docteurzoidberg/claudemetre/design/references/fusible/README.md

# Porte-fusible 5 × 20 : modèle 3D de référence

Porte-fusible de panneau pour cartouche 5 × 20 mm, à capuchon moleté. Il doit
protéger l'arrivée 12 V sur le LP-16. Ce modèle sert à Fusion.

Source : archive GrabCAD `fuse-holder-5-20mm-cartidge-1.snapshot.2.zip`
(<https://grabcad.com/library/fuse-holder-5-20mm-cartidge-1>). Export Fusion, en mm.
Rien n'indique qu'il vient du fabricant : cotes à confirmer sur la pièce reçue.

| Fichier | Contenu |
| --- | --- |
| `fuse_holder.step` | porte-fusible, 7 solides : capuchon, corps, deux cosses, écrou, deux rondelles. Envoyé dans Fusion : `claudometre/models/porte_fusible_5x20` |
| `fuse_holder.jpg` | aperçu fourni avec le modèle |

## Repère

Z est l'axe du porte-fusible, +Z va vers le capuchon, l'origine est près du
sommet du capuchon. Dans le STEP, écrou et rondelles sont posés sur le filet,
sans panneau.

## Cotes

Mesurées sur le STEP.

| Élément | Diamètre | Z |
| --- | --- | --- |
| Capuchon | Ø 14 à la base, Ø 12,5 environ sur le moletage | +0,5 à −7 |
| Collerette | Ø 15 | −7 à −10 |
| Filet | Ø 11 environ | −10 à −18,6 |
| Corps arrière | Ø 8, méplat à y = −3,5 | −18,6 à −30 |
| Cosse latérale | 3 de large, sur le méplat | −25,9 à −21,1 |
| Cosse arrière | 3 de large | −35 à −30 |

Écrou de 15 sur plats (17,3 sur angles), 2,5 d'épaisseur. Deux rondelles Ø 15
de 0,5.

## Pour une plaque de flanc

- **Devant le panneau** : 10,5, du capuchon à l'arrière de la collerette.
- **Derrière le panneau** : 20 jusqu'au bout du corps, 25 jusqu'au bout de la
  cosse arrière, fil non compté.
- **Épaisseur de panneau** : 5 au plus, une fois écrou et rondelles comptés
  (8,6 de filet).
- **Le filet est à mesurer.** Ø 11 sur le modèle, alors que ce type de
  porte-fusible se monte souvent en M12 : le perçage en dépend.
