docteurzoidberg/claudemetre/design/references/grabcad.md

# Modèles GrabCAD

Modèles tiers gardés dans `design/references/`, avec leur page d'origine.

| Modèle | Dossier | Page | Fichier téléchargé |
| --- | --- | --- | --- |
| Voltmètre SO-45 (Awesome Makes) | `so45/` | https://grabcad.com/library/so-45-voltmeter-1 | `so-45-voltmeter-1.snapshot.1.zip` |
| Afficheur TM1637 0,56" | `tm1637/` | https://grabcad.com/library/display-4-didi-led-tm1637-arduino-module-1 | `Display_4-Didi_LED_TM1637.stp` |
| Embase LP-16 2 pôles | `lp16/` | https://grabcad.com/library/cnlinko-connector-lp16-2-pole-1 | `cnlinko-connector-lp16-2-pole-1.snapshot.12.zip` |
| Embase LP-16 USB-C | `lp16/` | https://grabcad.com/library/cnlinko-connector-lp16-usbc-1 | `cnlinko-connector-lp16-usbc-1.snapshot.5.zip` |
| Carte MRD076A avec ESP32-S3 | `mrd076a/` | https://grabcad.com/library/mdr076a-esp32-s3-1 | `mdr076a-esp32-s3-1.snapshot.1.zip` |
| Porte-fusible 5 × 20 | `fusible/` | https://grabcad.com/library/fuse-holder-5-20mm-cartidge-1 | `fuse-holder-5-20mm-cartidge-1.snapshot.2.zip` |
