docteurzoidberg/claudemetre/design/fusion/FICHIERS_VALIDES.md

# Fichiers verrouillés

Ces fichiers ne doivent plus changer (pièces déjà imprimées, ou fichiers ré-enregistrés par l'utilisateur dans le
trancheur) : les générateurs ne les réécrivent pas et mettent la nouvelle version à part. Pour accepter une nouvelle
version : `imp3d valides retirer <projet> <fichier>`, régénérer, puis `imp3d valides ajouter …` (bibliothèque commune
`~/3d/impression-3d`). Empreinte = contenu utile du fichier (dates ignorées).

| Fichier | Validé le | Empreinte | Remarque |
|---|---|---|---|
| `print/fond-jauge-semaine.3mf` | 2026-11-05 | `59d5d0c1da` | ré-enregistré par l'utilisateur dans Snapmaker Orca le 29/10/2026 avec ses filaments (bloc <plate>) : verrouillé à sa demande le 02/11/2026 |
| `print/fond-jauge-session.3mf` | 2026-11-05 | `a135bd4ec4` | ré-enregistré par l'utilisateur dans Snapmaker Orca le 30/10/2026 avec ses filaments (bloc <plate>) : verrouillé à sa demande le 02/11/2026 |
