docteurzoidberg/claudemetre/design/cablage/index.html

Claudemètre · schéma de câblage

# Câblage du Claudemètre

Une carte ESP32-S3-DevKitC-1, deux voltmètres SO-45, l'afficheur TM1637 et le ruban du voyant CLAUDE. Huit fils, tous sur le connecteur J1, et une seule pièce ajoutée hors des modules : une diode.

Brochage de esphome/claudemetre.yaml · 06/11/2026

Carte vue de dessus, USB en bas. Les signaux partent du haut de J1 (broches 4 à 7) et du bas pour le ruban (broche 20), les alimentations des deux bouts (3V3 en 1, 5V0 et GND en 21 et 22). Un point marque une jonction, un pont un croisement sans contact. Dans les SO-45, le circuit interne avec la résistance à ajouter. Ordre des broches du TM1637 et des pastilles du ruban à lire sur la sérigraphie ; couleurs de fil proposées.

## Fil par fil

Fil | Broche J1 | Vers | Remarque
bleu | 4 · GPIO4 | SO-45 A (session), borne + | PWM 25 kHz, 1,2 mA au plus
violet | 5 · GPIO5 | SO-45 B (semaine), borne + | PWM 25 kHz, 1,2 mA au plus
vert | 6 · GPIO6 | TM1637, CLK
marron | 7 · GPIO7 | TM1637, DIO
orange | 1 · 3V3 | TM1637, VCC | en 3,3 V, pas en 5 V (voir plus bas)
jaune | 20 · GPIO14 | Ruban, DIN (côté entrée) | données en 3,3 V, sans level shifter
rouge | 21 · 5V0 | Diode 1N400x, puis ruban +5V | anode côté carte, bague côté ruban
noir | 22 · GND | Bornes − des deux SO-45, GND du TM1637, GND du ruban | masse commune

## Au montage

### Une 6,2 kΩ dans chaque SO-45

Soudée en parallèle sur R_s seule, jamais sur les bornes du voltmètre. Rien à dessouder. Entre les bornes, on doit lire ≈ 2,78 kΩ (A) et ≈ 2,82 kΩ (B) ; le 100 % imprimé tombe alors vers 2,93 et 2,95 V, sous les 3,3 V du GPIO.

### Jauges sans pièce externe

La résistance interne limite le courant à 1,2 mA sous 3,3 V : pas de résistance de protection. Un condensateur aux bornes seulement si l'aiguille tremble à l'essai.

### Jamais de 5 V sur un GPIO

Le 5V0 ne va qu'à la diode du ruban. Le TM1637 reste en 3V3 : son module tire CLK et DIO à son VCC, donc alimenté en 5 V il mettrait 5 V sur GPIO6 et GPIO7.

### Ruban piloté en 3,3 V

La 1N400x fait tomber l'alimentation du ruban vers 4,3 V. Le seuil haut du WS2812B (0,7 × VDD ≈ 3,0 V) passe sous les 3,3 V de GPIO14. Montage à valider sur breadboard.

### Tout sur J1

Les huit fils partent du connecteur de gauche (USB en bas) : broches 1, 4 à 7, 20, 21 et 22. La carte diymore est un clone : vérifier la sérigraphie avant de souder.

## Alimentation 5 V

Consommateur | Courant
ESP32-S3 en WiFi | ≈ 100 mA, pics ≈ 350 mA
Ruban, 4 LED (ambre à 60 %) | ≈ 80 mA, 240 mA en blanc plein
TM1637 | quelques dizaines de mA
Deux SO-45 | ≈ 2 mA

Moins de 0,7 A au pire : un chargeur USB 5 V / 1 A suffit. Si l'on passe à un module 230 V → 5 V (question ouverte du cahier des charges), il arrive sur 5V0 et GND, à la place du câble USB.

Sources : esphome/claudemetre.yaml, esphome/temoin.yaml, docs/cahier-des-charges.md, design/references/so45/README.md. Courants de l'ESP32, du TM1637 et du ruban : ordres de grandeur, pas des mesures.
