docteurzoidberg/claudemetre/design/gallery/img/jj_fusion.jpg

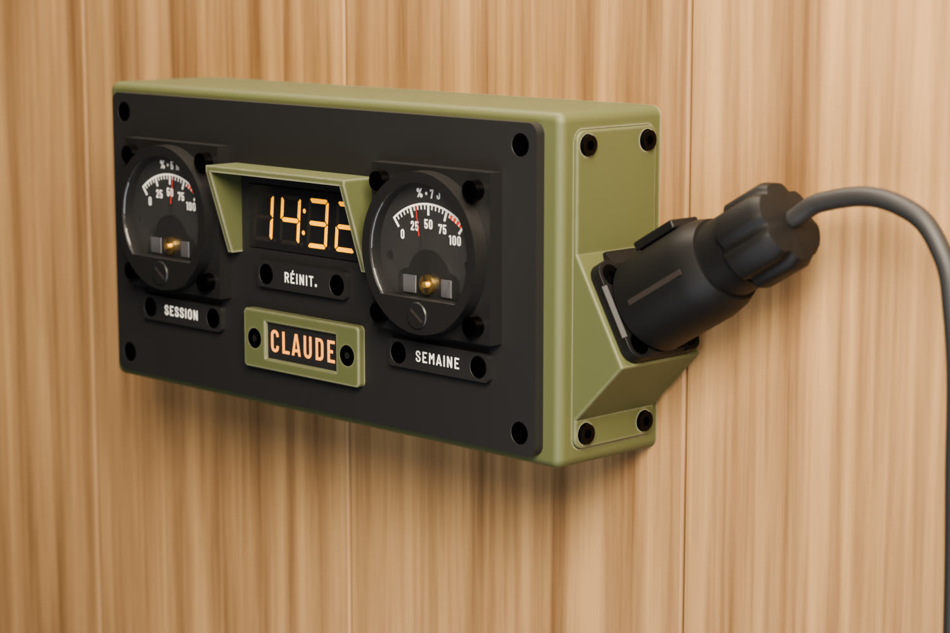
design/gallery/img/jj_fusion.jpg
