docteurzoidberg/claudemetre/design/gallery/img/jj_fusion_detail.jpg

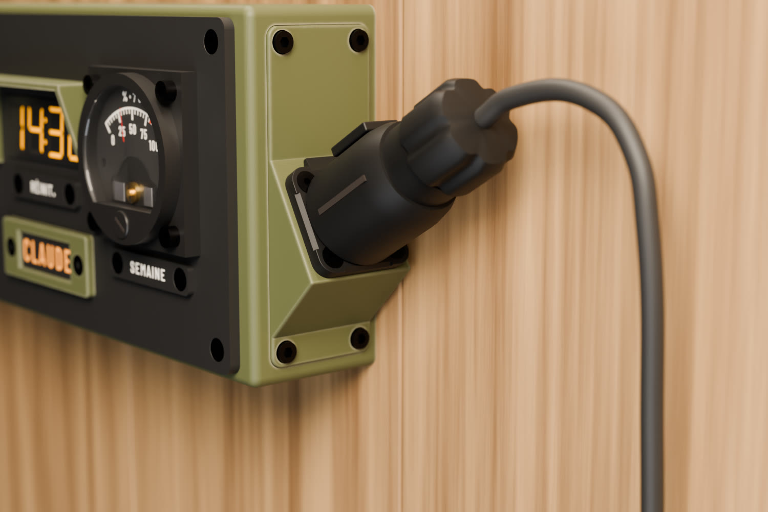
design/gallery/img/jj_fusion_detail.jpg
