docteurzoidberg/claudemetre/design/references/fusible/fuse_holder.jpg

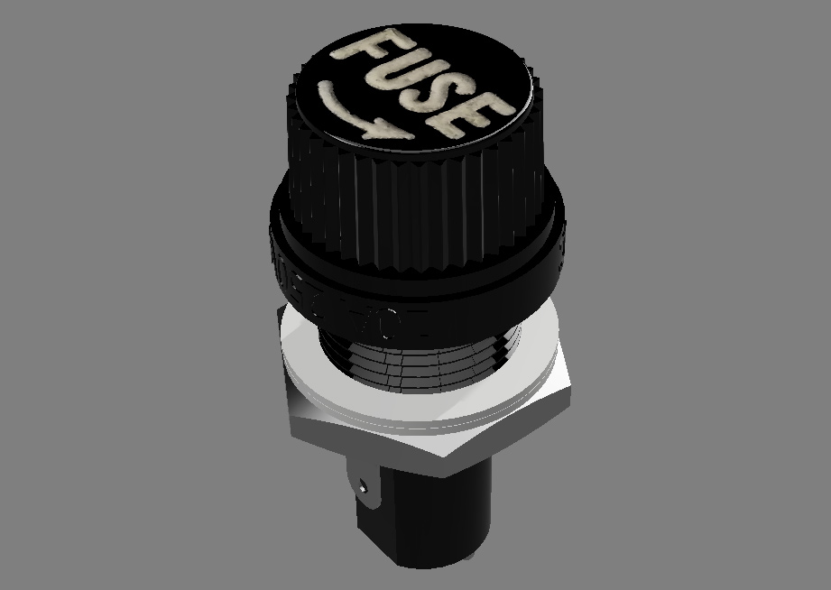
design/references/fusible/fuse_holder.jpg
