docteurzoidberg/claudemetre/design/references/mrd076a/MDR076A+ESP32-S3.jpg

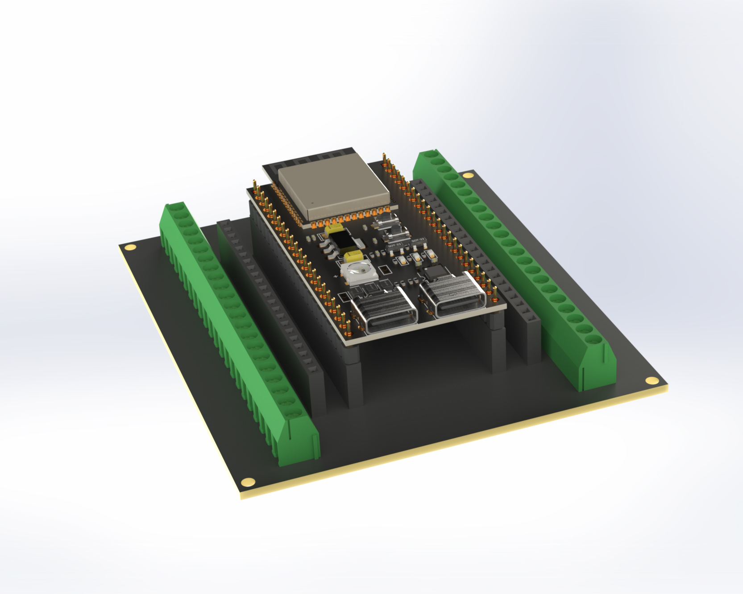
design/references/mrd076a/MDR076A+ESP32-S3.jpg
