docteurzoidberg/claudemetre/design/references/so45/cadran_photo.jpg

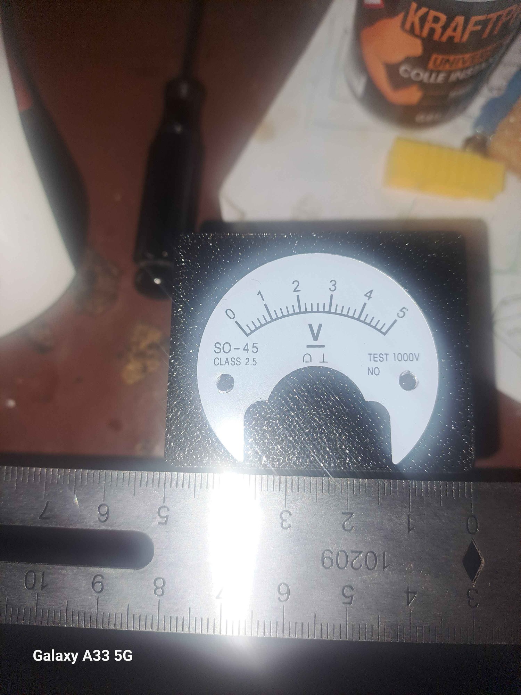
design/references/so45/cadran_photo.jpg
