docteurzoidberg/claudemetre/design/references/so45/cadran_redresse.jpg

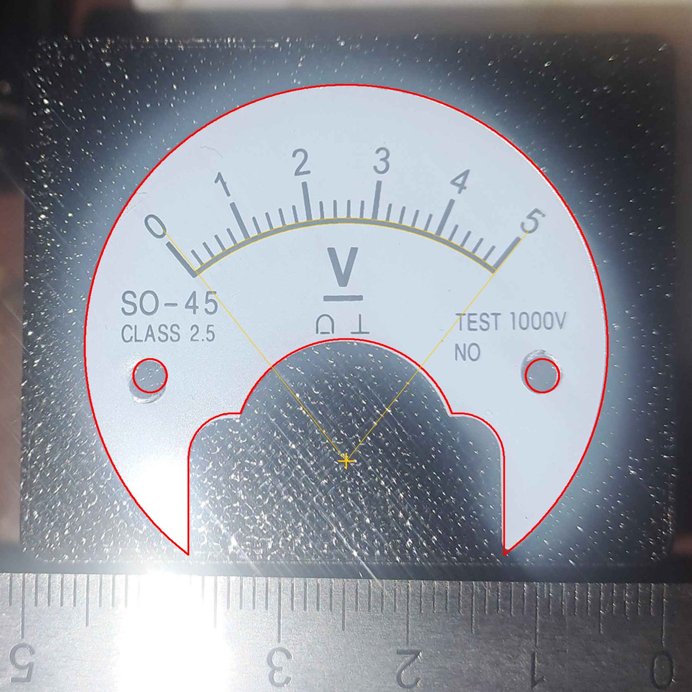
design/references/so45/cadran_redresse.jpg
