docteurzoidberg/claudemetre/design/references/so45/so-45-voltmeter-back.png

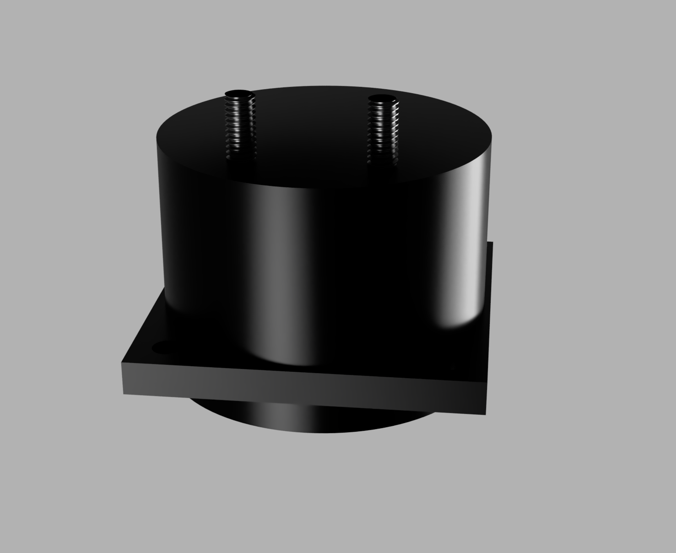
design/references/so45/so-45-voltmeter-back.png
