docteurzoidberg/claudemetre/design/references/so45/so-45-voltmeter-front.png

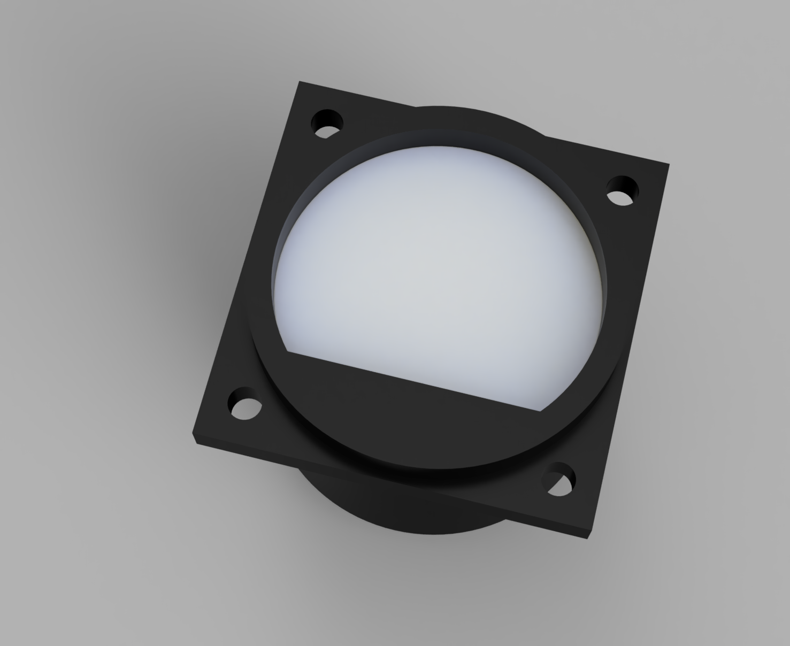
design/references/so45/so-45-voltmeter-front.png
