docteurzoidberg/claudemetre/design/references/so45/so-45-voltmeter-side.png

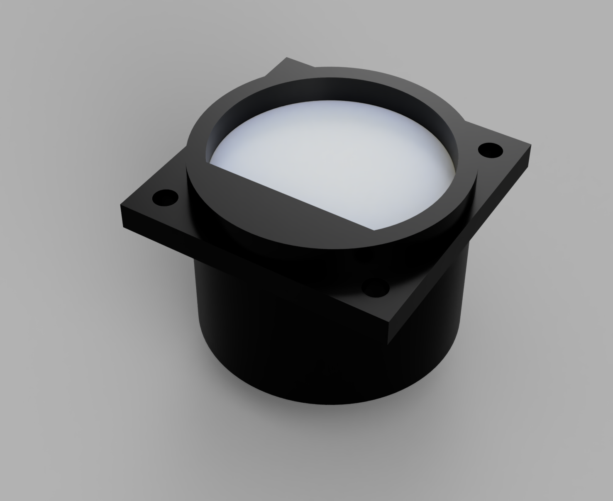
design/references/so45/so-45-voltmeter-side.png
