docteurzoidberg/claudemetre/design/references/so45/voltmetre_face.jpg

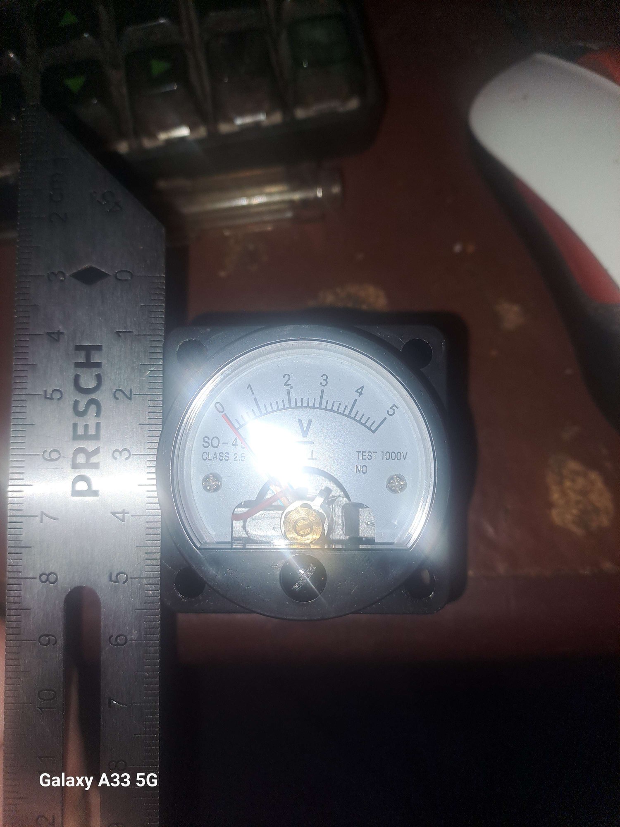
design/references/so45/voltmetre_face.jpg
