docteurzoidberg/claudemetre/design/renders/preview/jj_fusion_face_zoom.png

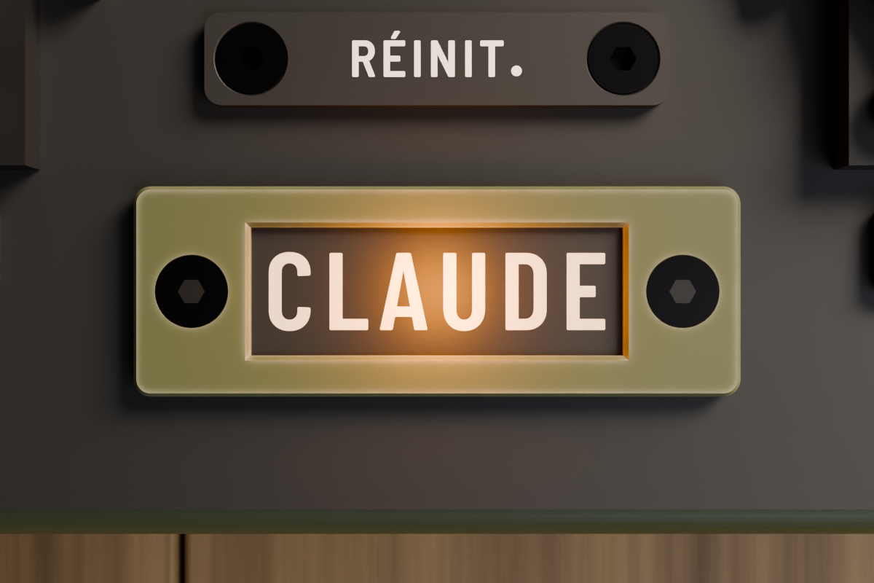
design/renders/preview/jj_fusion_face_zoom.png
