docteurzoidberg/claudemetre/design/plaquettes/dxf/semaine.dxf

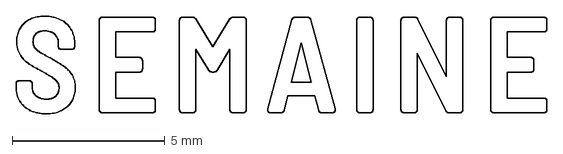
[picture p14: CAD file, 2026-11-05]
design/plaquettes/dxf/semaine.dxf
17.4 x 3.19 mm
