docteurzoidberg/claudemetre/design/fusion/print/fond-jauge-semaine.3mf

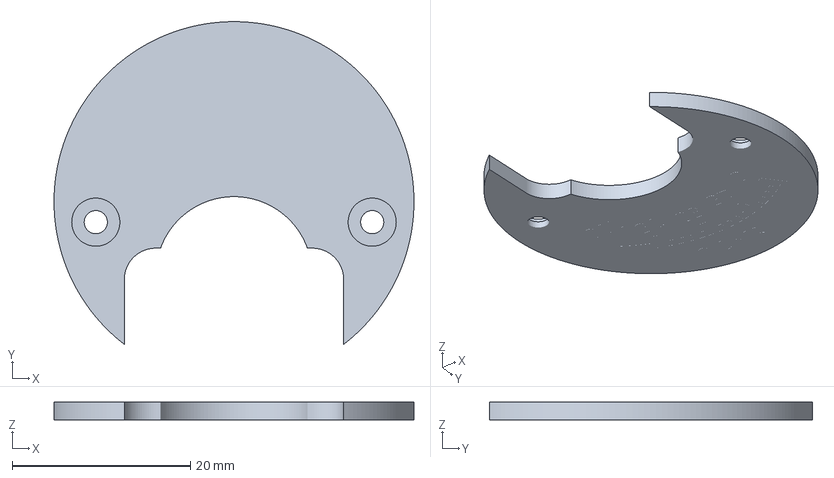
[picture p15: CAD file, 2026-11-05]
design/fusion/print/fond-jauge-semaine.3mf
40.4 x 36.2 x 2.00 mm
