docteurzoidberg/claudemetre/design/plaquettes/dxf/semaine_flip.dxf

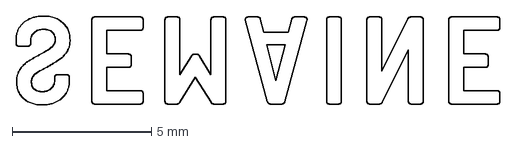
[picture p16: CAD file, 2026-11-05]
design/plaquettes/dxf/semaine_flip.dxf
17.4 x 3.19 mm
