docteurzoidberg/claudemetre/design/fusion/cadran_dxf/echelle.dxf

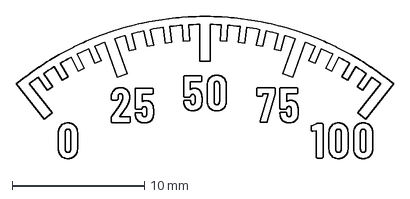
[picture p17: CAD file, 2026-11-05]
design/fusion/cadran_dxf/echelle.dxf
28.6 x 10.8 mm
