docteurzoidberg/claudemetre/design/fusion/print/plaque_bossage_fusible.3mf

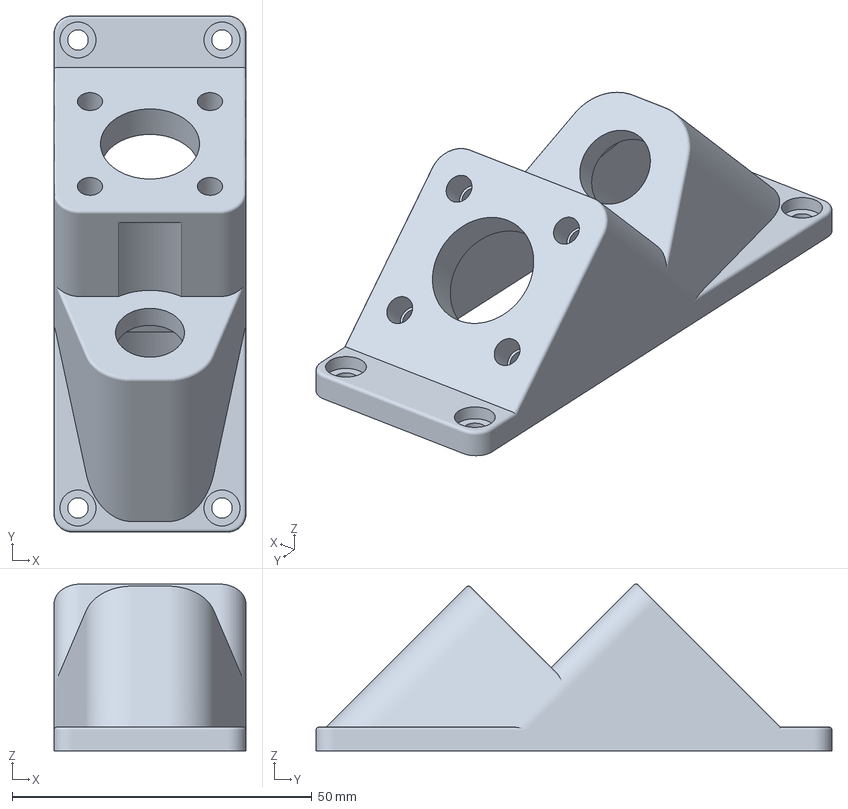
[picture p18: CAD file, 2026-11-05]
design/fusion/print/plaque_bossage_fusible.3mf
32.0 x 86.0 x 27.8 mm
