docteurzoidberg/claudemetre/design/references/fusible/fuse_holder.step

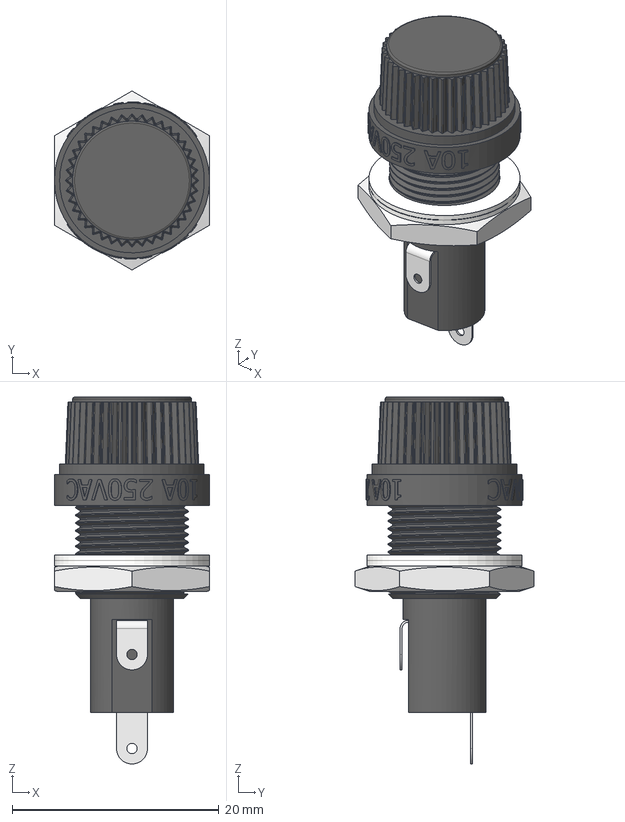
[picture p19: CAD file, 2026-11-05]
design/references/fusible/fuse_holder.step
15.0 x 17.3 x 35.5 mm
