docteurzoidberg/claudemetre/design/references/lp16/LP-16-2pole.step

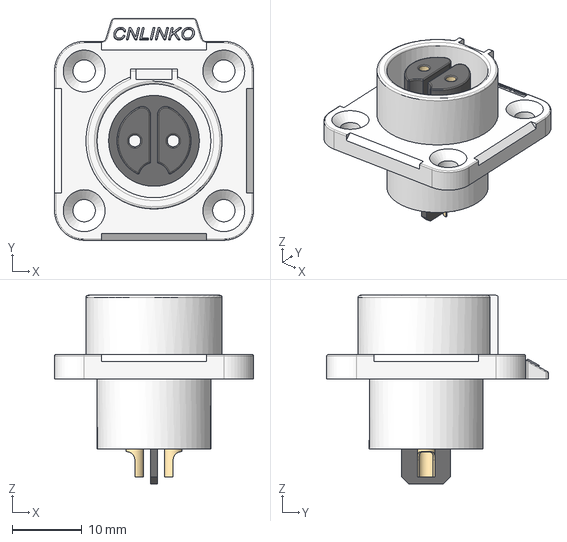
[picture p20: CAD file, 2026-11-05]
design/references/lp16/LP-16-2pole.step
28.5 x 31.8 x 27.0 mm
