docteurzoidberg/claudemetre/design/references/so45/so-45-voltmeter.step

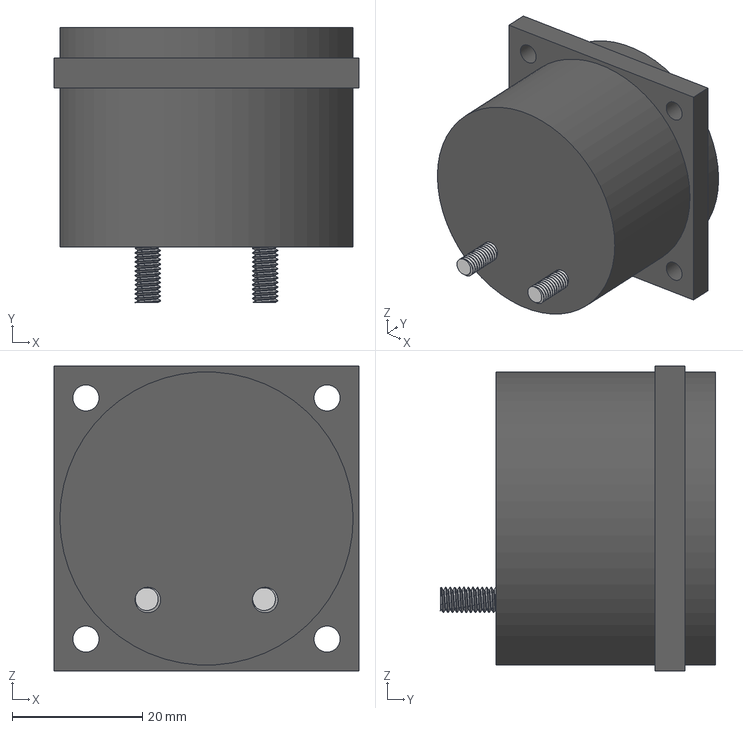
[picture p22: CAD file, 2026-11-05]
design/references/so45/so-45-voltmeter.step
46.8 x 42.2 x 46.8 mm
