docteurzoidberg/claudemetre/design/references/tm1637/Display_4-Didi_LED_TM1637.stp

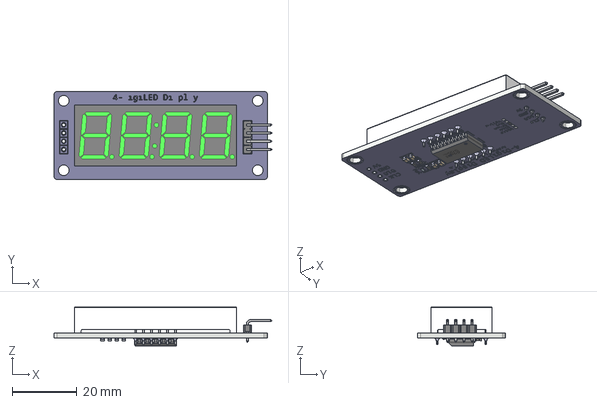
[picture p23: CAD file, 2026-11-05]
design/references/tm1637/Display_4-Didi_LED_TM1637.stp
67.4 x 27.2 x 12.0 mm
