docteurzoidberg/claudemetre/design/temoin/export/claude_boite.stl

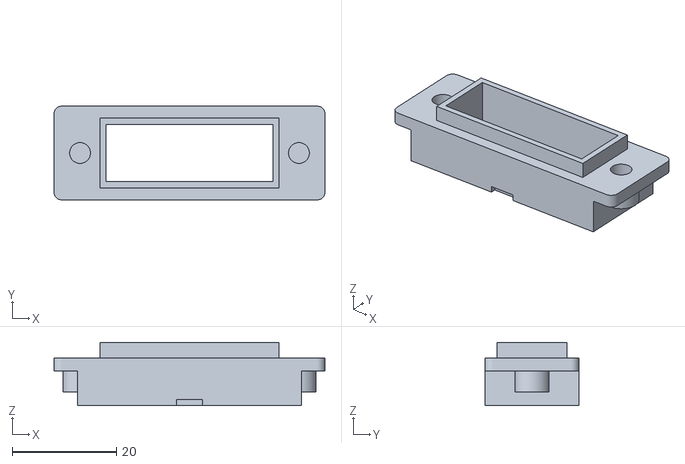
[picture p24: CAD file, 2026-11-05]
design/temoin/export/claude_boite.stl
52.0 x 18.0 x 12.1
