docteurzoidberg/claudemetre/design/fusion/cadran_dxf/texte.dxf

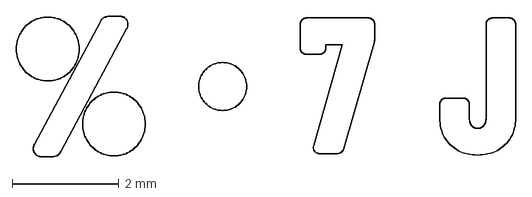
[picture p25: CAD file, 2026-11-05]
design/fusion/cadran_dxf/texte.dxf
9.35 x 2.63 mm
