docteurzoidberg/claudemetre/design/fusion/print/platine.3mf

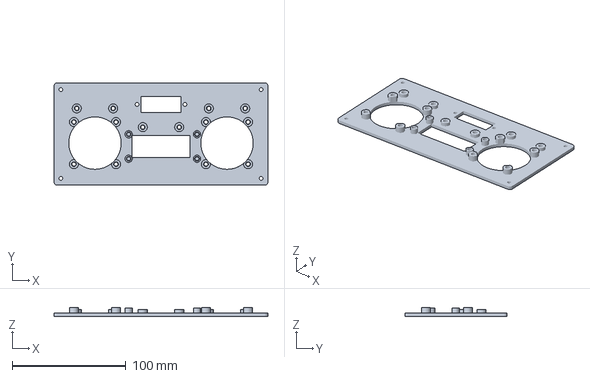
[picture p26: CAD file, 2026-11-05]
design/fusion/print/platine.3mf
188.0 x 90.0 x 8.00 mm
