docteurzoidberg/claudemetre/design/plaquettes/dxf/reinit.dxf

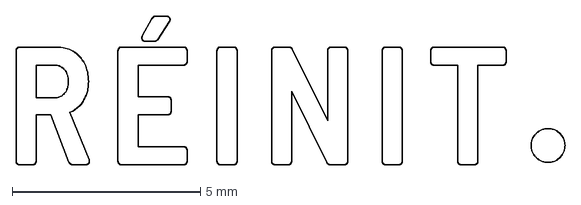
[picture p27: CAD file, 2026-11-05]
design/plaquettes/dxf/reinit.dxf
14.6 x 3.94 mm
