docteurzoidberg/claudemetre/design/references/lp16/LP16-USBC.step

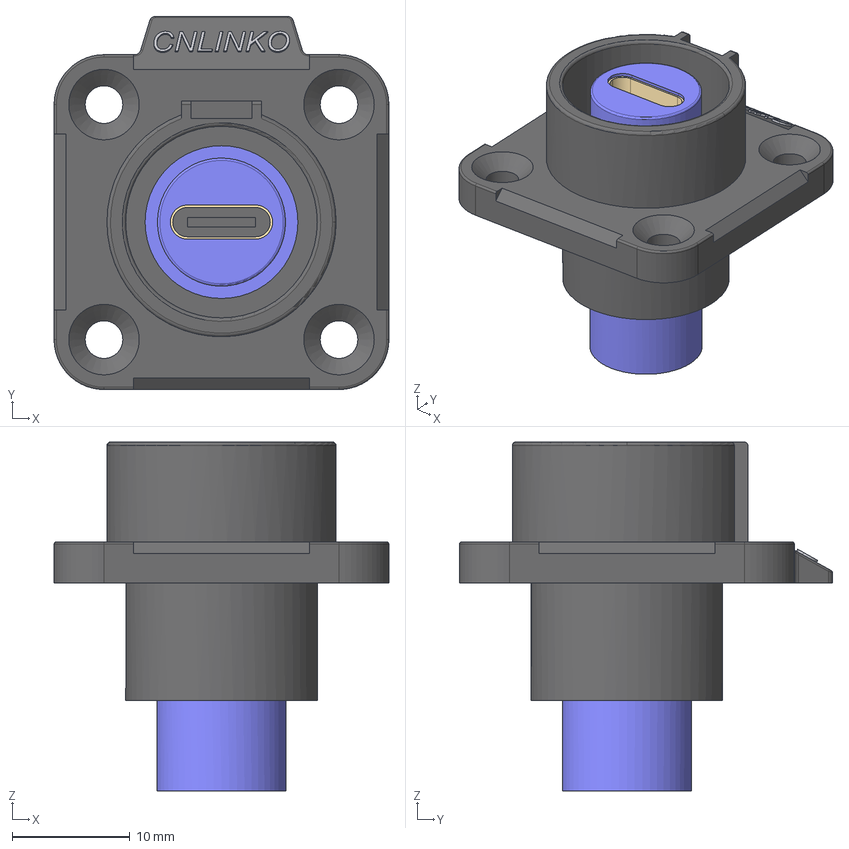
[picture p28: CAD file, 2026-11-05]
design/references/lp16/LP16-USBC.step
28.5 x 31.8 x 29.7 mm
