docteurzoidberg/claudemetre/design/references/mrd076a/MDR076A.STEP

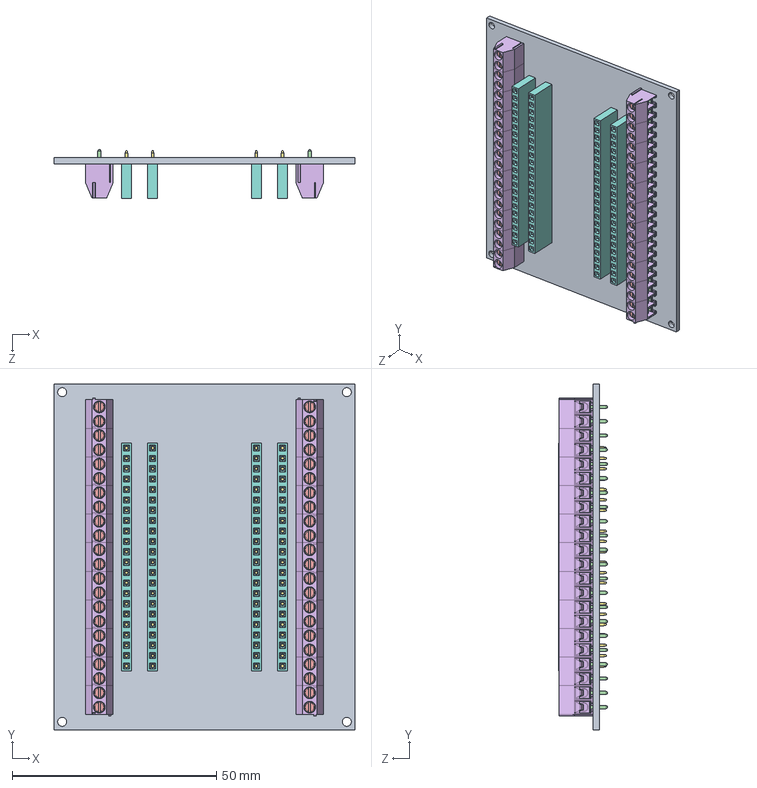
[picture p29: CAD file, 2026-11-05]
design/references/mrd076a/MDR076A.STEP
73.6 x 84.7 x 12.0 mm
MDR076A
2445P Screw Terminal Block- 22 Pin, 3.5mm Pitch, Side Entry x 2
Terminal Block- 22 Pin, 2.54mm x 4
