docteurzoidberg/claudemetre/design/temoin/export/claude_panneau_essai.3mf

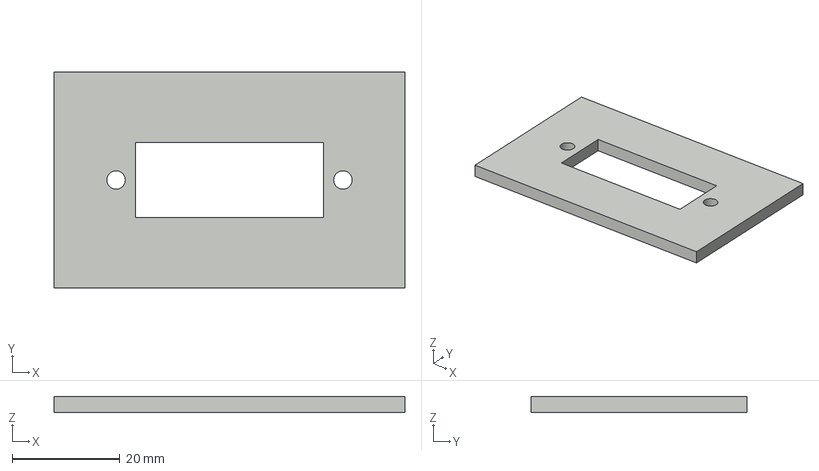
[picture p30: CAD file, 2026-11-05]
design/temoin/export/claude_panneau_essai.3mf
65.0 x 40.0 x 3.00 mm
