docteurzoidberg/claudemetre/design/fusion/cadran_dxf/zone.dxf

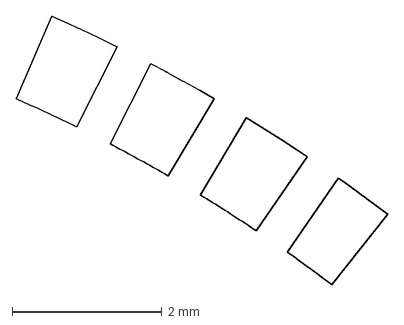
[picture p31: CAD file, 2026-11-05]
design/fusion/cadran_dxf/zone.dxf
4.96 x 3.59 mm
