docteurzoidberg/claudemetre/design/plaquettes/dxf/reinit_flip.dxf

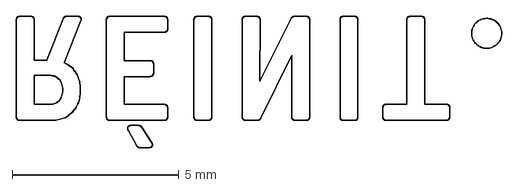
[picture p32: CAD file, 2026-11-05]
design/plaquettes/dxf/reinit_flip.dxf
14.6 x 3.94 mm
