docteurzoidberg/claudemetre/design/temoin/export/claude_legende_masque.stl

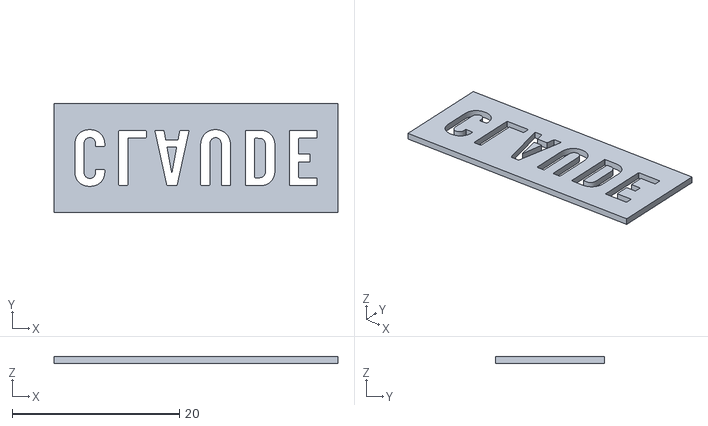
[picture p33: CAD file, 2026-11-05]
design/temoin/export/claude_legende_masque.stl
34.0 x 13.0 x 0.8
