docteurzoidberg/claudemetre/design/fusion/print/patron.3mf

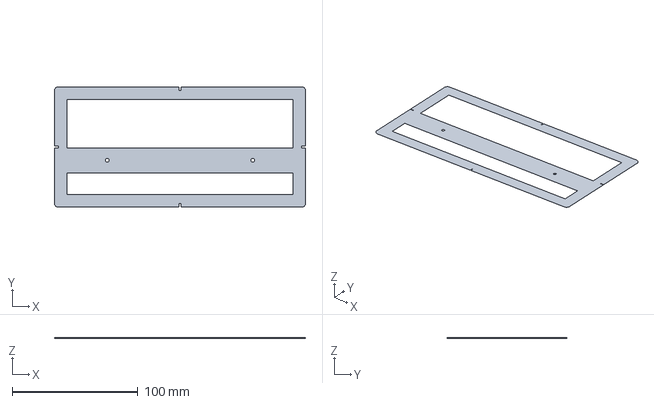
[picture p34: CAD file, 2026-11-05]
design/fusion/print/patron.3mf
200.0 x 96.0 x 0.6 mm
