docteurzoidberg/claudemetre/design/temoin/export/claude.step

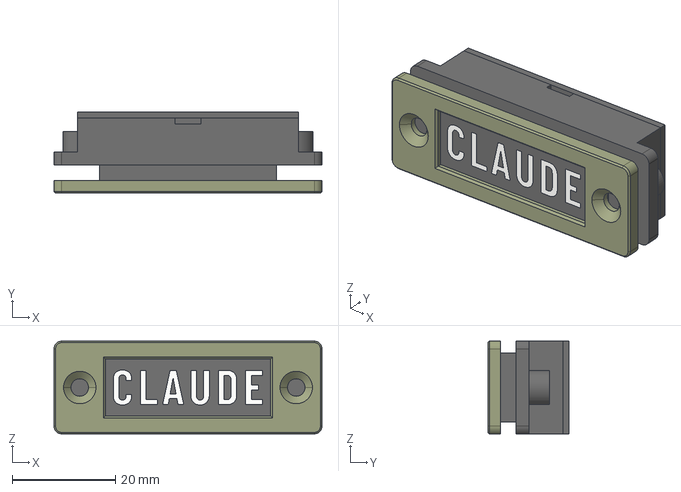
[picture p35: CAD file, 2026-11-05]
design/temoin/export/claude.step
52.0 x 15.8 x 18.0 mm
