docteurzoidberg/claudemetre/design/plaquettes/dxf/session.dxf

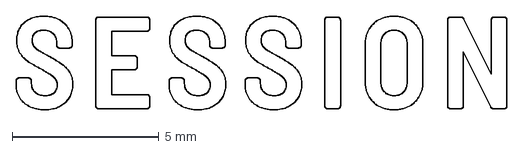
[picture p36: CAD file, 2026-11-05]
design/plaquettes/dxf/session.dxf
16.7 x 3.20 mm
