docteurzoidberg/claudemetre/design/temoin/export/claude_legende_voile.stl

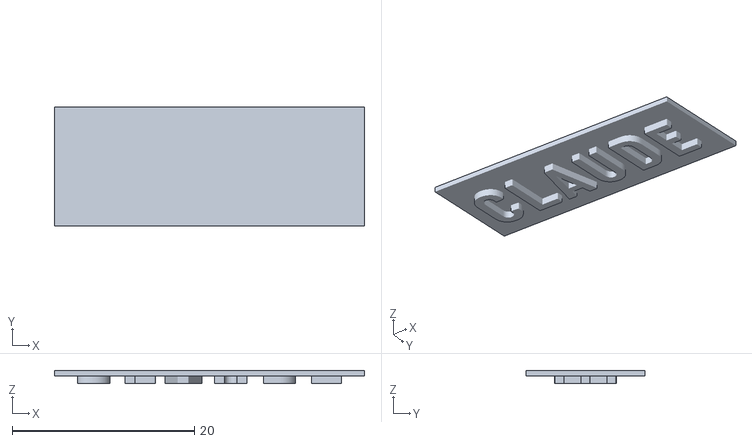
[picture p37: CAD file, 2026-11-05]
design/temoin/export/claude_legende_voile.stl
34.0 x 13.0 x 1.40
