docteurzoidberg/claudemetre/design/fusion/print/plaque_bossage.3mf

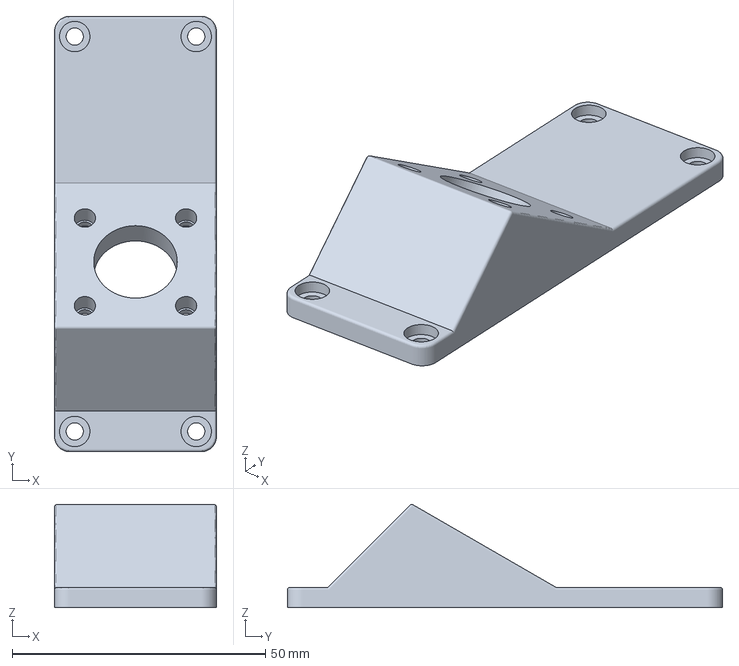
[picture p38: CAD file, 2026-11-05]
design/fusion/print/plaque_bossage.3mf
32.0 x 86.0 x 20.4 mm
