docteurzoidberg/claudemetre/design/plaquettes/dxf/session_flip.dxf

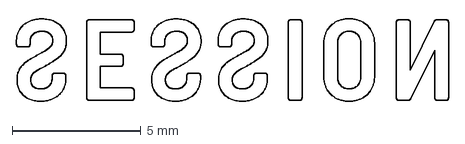
[picture p39: CAD file, 2026-11-05]
design/plaquettes/dxf/session_flip.dxf
16.7 x 3.20 mm
