docteurzoidberg/claudemetre/design/temoin/export/claude_fond.stl

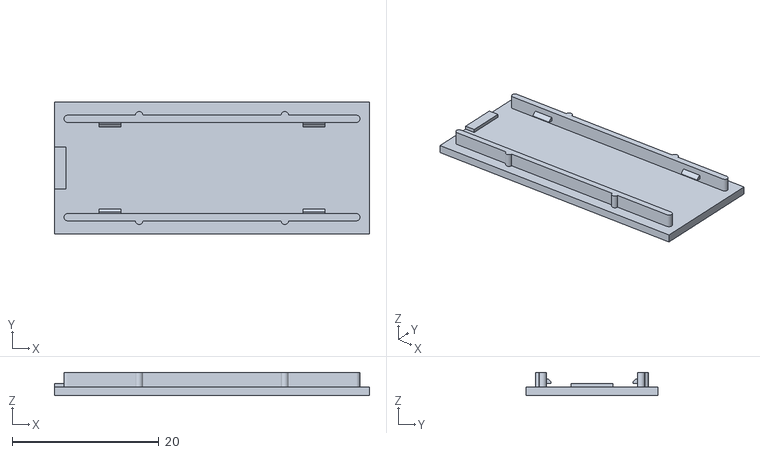
[picture p40: CAD file, 2026-11-05]
design/temoin/export/claude_fond.stl
42.9 x 18.0 x 3.20
