docteurzoidberg/claudemetre/design/fusion/print/plaque_flanc.3mf

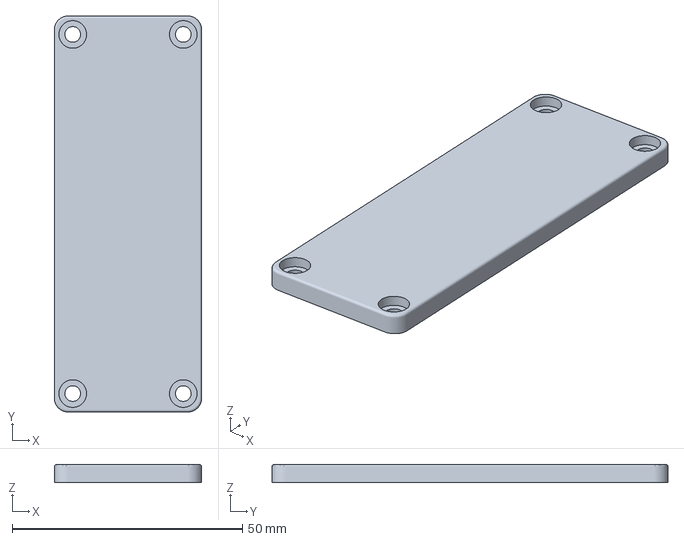
[picture p41: CAD file, 2026-11-05]
design/fusion/print/plaque_flanc.3mf
32.0 x 86.0 x 4.00 mm
