docteurzoidberg/claudemetre/design/temoin/export/claude_cadre.3mf

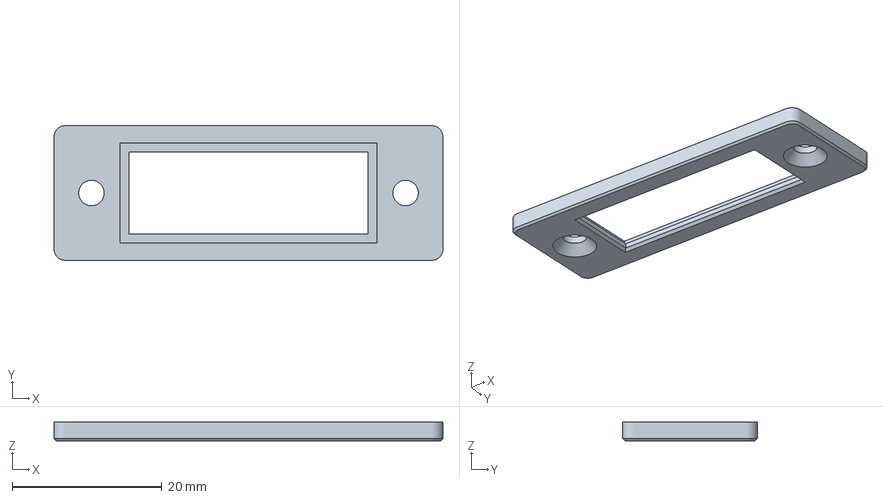
[picture p42: CAD file, 2026-11-05]
design/temoin/export/claude_cadre.3mf
52.0 x 18.0 x 2.50 mm
