docteurzoidberg/claudemetre/design/fusion/print/plaquettes.3mf

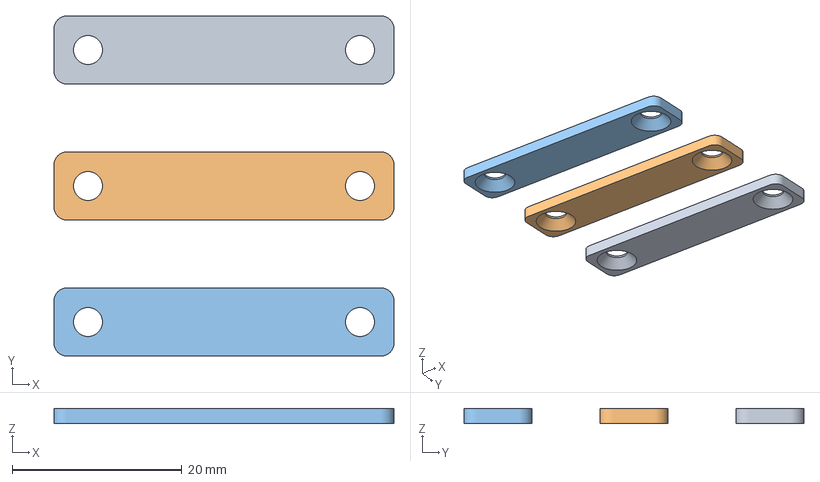
[picture p43: CAD file, 2026-11-05]
design/fusion/print/plaquettes.3mf
40.0 x 40.0 x 1.80 mm
plaquette_session
plaquette_semaine
plaquette_reinit
