docteurzoidberg/claudemetre/design/temoin/export/claude_boite_fond.3mf

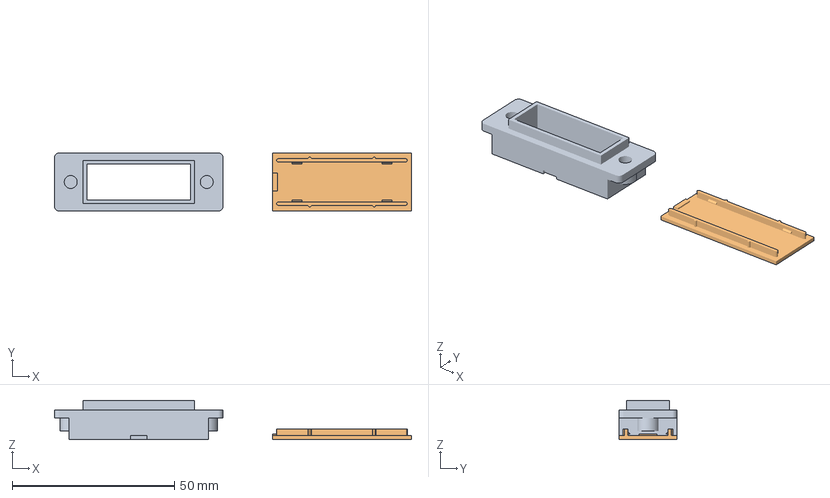
[picture p44: CAD file, 2026-11-05]
design/temoin/export/claude_boite_fond.3mf
110.2 x 18.0 x 12.1 mm
boite
fond
