docteurzoidberg/claudemetre/design/fusion/print/coque.3mf

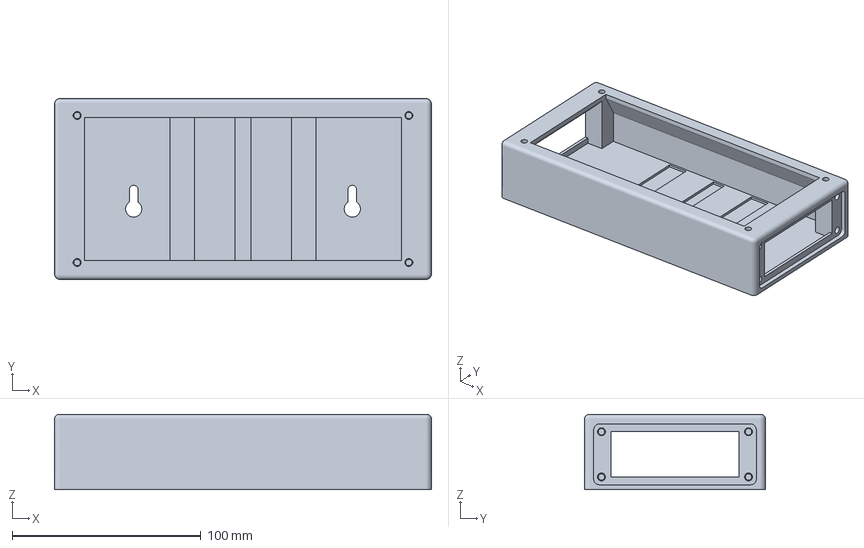
[picture p45: CAD file, 2026-11-05]
design/fusion/print/coque.3mf
200.0 x 96.0 x 40.0 mm
