docteurzoidberg/claudemetre/design/temoin/export/claude_legende.3mf

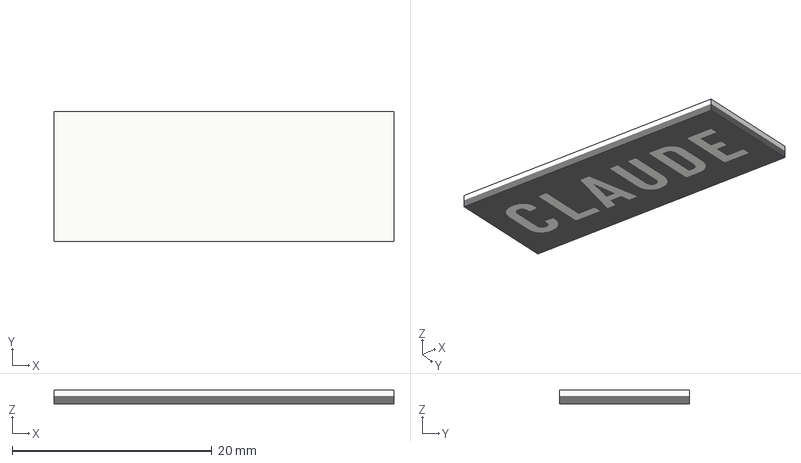
[picture p46: CAD file, 2026-11-05]
design/temoin/export/claude_legende.3mf
34.0 x 13.0 x 1.40 mm
