docteurzoidberg/claudemetre/design/fusion/print/visiere.3mf

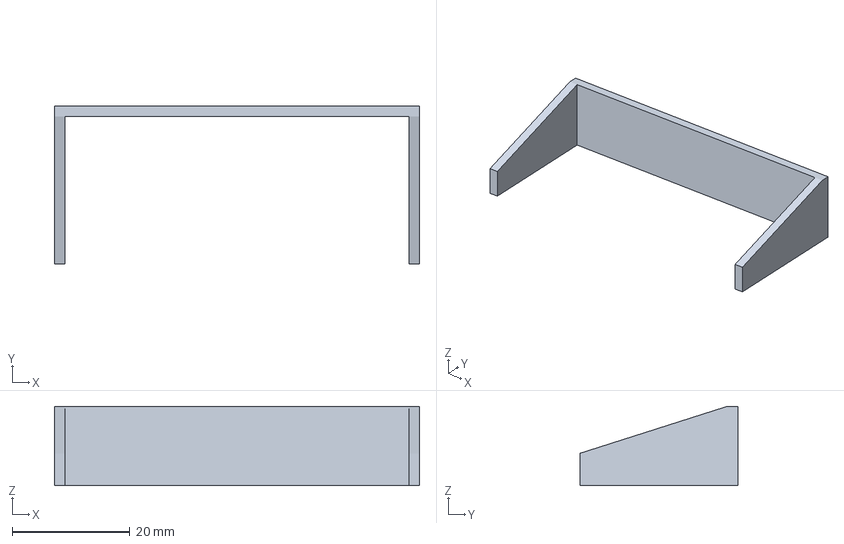
[picture p47: CAD file, 2026-11-05]
design/fusion/print/visiere.3mf
62.0 x 26.9 x 13.5 mm
