docteurzoidberg/claudemetre/design/fusion/print/clips.3mf

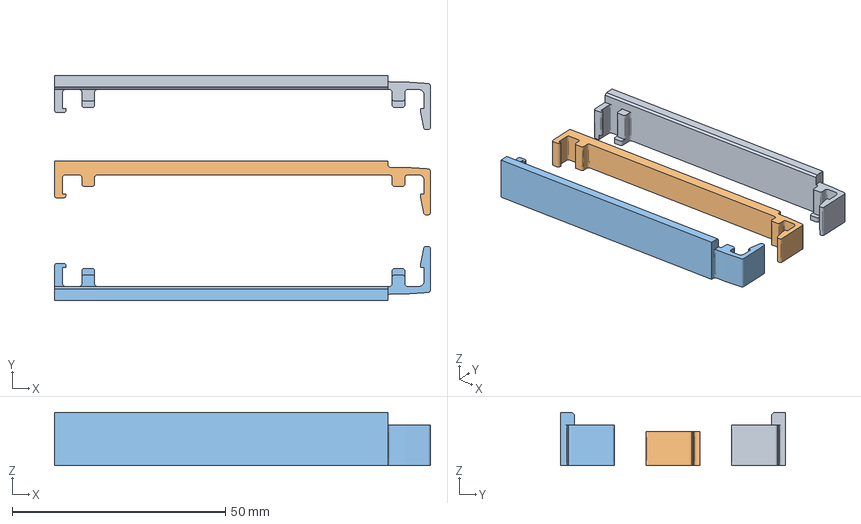
[picture p48: CAD file, 2026-11-05]
design/fusion/print/clips.3mf
88.1 x 52.7 x 12.5 mm
clip_aile
clip_milieu
clip_aile_miroir
