docteurzoidberg/claudemetre/(list of files, cad)

Other CAD files:
design/fusion/print/fond-jauge-session.3mf
design/blender/scenes/jj_fusion.blend
design/blender/scenes/jj_fusion_detail.blend
design/blender/scenes/jj_fusion_face.blend
design/blender/scenes/jj_fusion_soir.blend
design/references/lp16/LP-16-2pole.iges
design/references/lp16/LP16-USBC.iges
design/references/so45/so-45-voltmeter.f3d
design/temoin/export/claude_cadre.stl
design/temoin/export/claude_panneau_essai.stl
