docteurzoidberg/claudemetre/design/fusion/print/fond-jauge-semaine_apercu.png

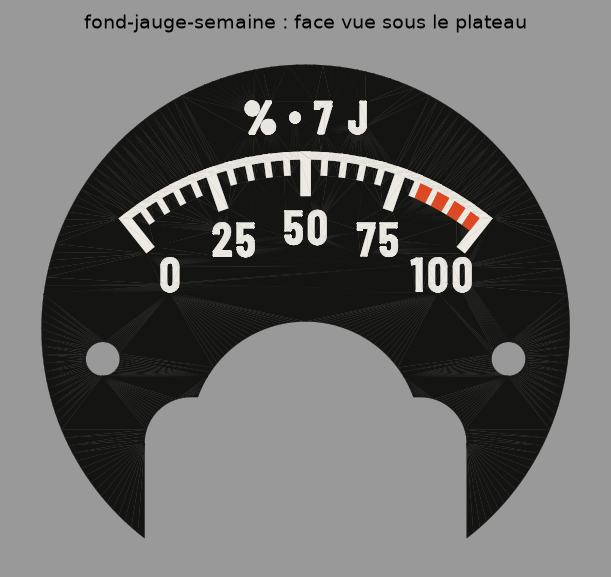
design/fusion/print/fond-jauge-semaine_apercu.png
