docteurzoidberg/claudemetre/(commit log)

2026-11-05 Claudemètre : objet mural qui affiche l'usage du forfait Claude
    Deux jauges analogiques, un afficheur 7 segments et un témoin lumineux,
    pilotés par un ESP32 sous ESPHome et Home Assistant.
    [Display_4-Didi_LED_TM1637.stp, LP-16-2pole.iges, LP-16-2pole.step, LP16-USBC.iges, LP16-USBC.step, MDR076A+ESP32-S3.STEP, MDR076A.STEP, claude.step]
2026-11-05 Afficheur : choix entre heure de reset et temps restant
    Select « Afficheur mode » dans HA : heure du reset (HH.MM) ou temps
    restant (-H.MM, arrondi à la minute supérieure), décompté par l'ESP32
    sans le PC. Le mode survit à un redémarrage.
    Doc : le module n'a pas de deux-points, seulement un point entre chaque
    chiffre. La carte Lovelace et les modèles 3D en dessinent encore un :
    noté dans les questions ouvertes.
    [claudemetre.yaml]
2026-11-05 Afficheur : animations au démarrage et au reset
    Démarrage : un trait fait le tour de l'afficheur et s'allonge pendant
    les 6 s du test des aiguilles, jusqu'à 88.88.
    Reset de la session : la dernière valeur clignote 5 s à pleine
    luminosité, puis --.--. Seulement si le reset a été vu à venir : rien au
    redémarrage sur un reset déjà passé.
    [claudemetre.yaml]
2026-11-05 Afficheur : le démarrage finit sans 88.88
    Le trait referme le pourtour à la fin des 6 s du test, et la valeur
    s'affiche aussitôt après.
2026-11-05 Publication : README, licences et export de la platine
    README pour les humains. Code sous MIT, conception sous CC BY-SA 4.0,
    modèles tiers sous la licence de leurs auteurs. Scripts pour sortir la
    platine en 3MF, à lancer dans Fusion.
2026-11-05 Platine : 3MF à imprimer
    Sortie de la version 28 du design, PETG noir, face avant sur le plateau.
    Dans le dépôt, la platine n'avait que son script de construction.
    [platine.3mf]
2026-11-05 Docs : version anglaise du README et des docs
    Le français reste à sa place ; docs/en/ en porte la traduction et le
    README racine y renvoie en première ligne. Corrige aussi une ligne de
    docs/logiciel.md que GitHub affichait comme une citation.
2026-11-05 README : drapeaux sur les liens de langue
    Ignore aussi CLAUDE.local.md, où passe la consigne de retraduction
    de docs/en/, retirée de CLAUDE.md.
2026-11-05 CLAUDE.md : consignes personnelles passées en local
    Les skills du poste et la règle des artefacts rejoignent CLAUDE.local.md.
    Les plans PLAN-*.md en cours restent hors du dépôt.
2026-11-05 Références : porte-fusible 5 × 20
    Modèle STEP GrabCAD et cotes, pour le design Fusion.
    [fuse_holder.step]
2026-11-05 Plaques : connecteurs dans leur composant, plaque à fusible
    Chaque plaque regroupe ses connecteurs et leur visserie ; on affiche
    celle qu'on veut et on masque les autres. Nouveau composant
    plaque_bossage_fusible : LP-16 et porte-fusible 5 × 20, forme Gorge
    (claudometre v30). L'export suit les plaques masquées.
    variants6.py est adapté, mais pas encore lancé dans Blender.
2026-11-05 Maquette : choix de la plaque et de ses connecteurs
    Pleine, LP-16 ou LP-16 et fusible, aussi par ?plaque= dans l'adresse.
    Modèle régénéré depuis claudometre v30.
2026-11-05 Hooks Git : valeurs privées au commit, docs anglaises au push
    pre-commit refuse un lien d'artefact ou une valeur de prive.env dans les
    lignes ajoutées. pre-push refuse des docs françaises en avance sur leur
    version anglaise et renvoie au skill regenerer-docs-en.
    À activer une fois par clone : git config core.hooksPath .githooks
2026-11-05 Skills du projet : maquette, rendus, 3MF, plaques, avant le push
    regenerer-3mf remplace cadrans-3mf et couvre toutes les pièces.
    regenerer-maquette reprend le build de la page autonome et son test.
    Les étapes Fusion, Blender et 3MF n'ont pas encore été rejouées.
2026-11-05 Plaques : 3MF d'essai de la plaque à fusible
    La hauteur de chaque plaque est mesurée sur son corps : plaque_bossage_fusible
    n'a pas de paramètre de saillie. Le 3MF reste à imprimer pour confirmer le filet
    du porte-fusible, l'écrou et la tenue du tube.
    [plaque_bossage_fusible.3mf]
2026-11-06 Voyant : ruban sur GPIO14
    Le fil DIN passe de GPIO15 à GPIO14 (broche 20 de J1) : firmware, docs
    et schéma de câblage.
2026-11-06 Activité : fin des sous-agents web-fetch par SubagentHandback
    Un sous-agent web-fetch au premier plan n'émet pas SubagentStop : il restait
    compté une heure et le voyant respirait sans activité. Sa fin se lit désormais
    sur le PostToolUse de SubagentHandback.
